tokla-chiya/VL53L9_KICAD/tmp/pdfs/reference-3.png

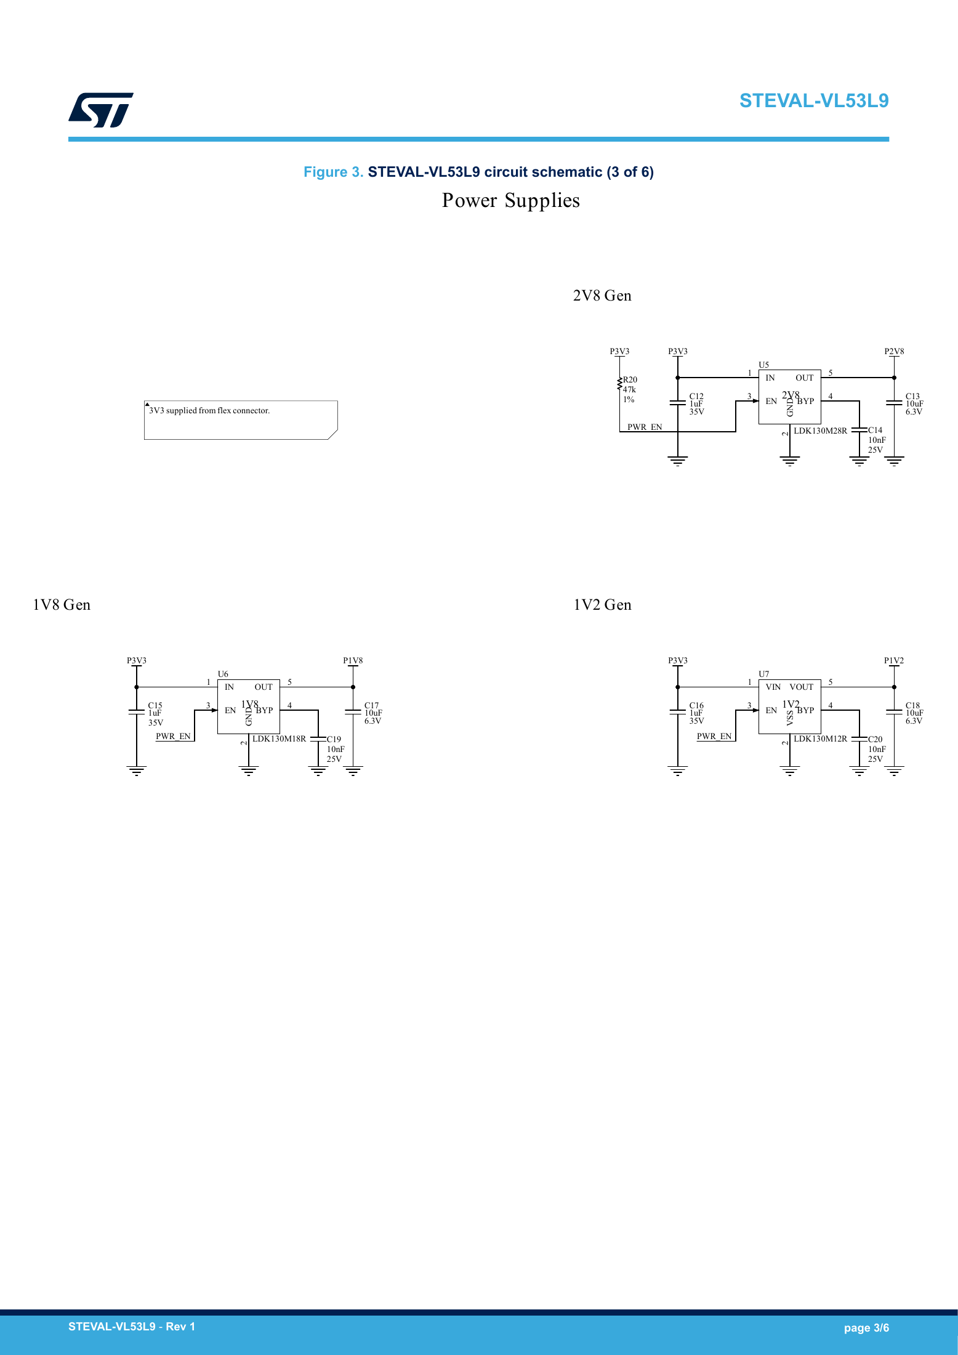
tmp/pdfs/reference-3.png
