tokla-chiya/VL53L9_KICAD/tmp/pdfs/reference-4.png

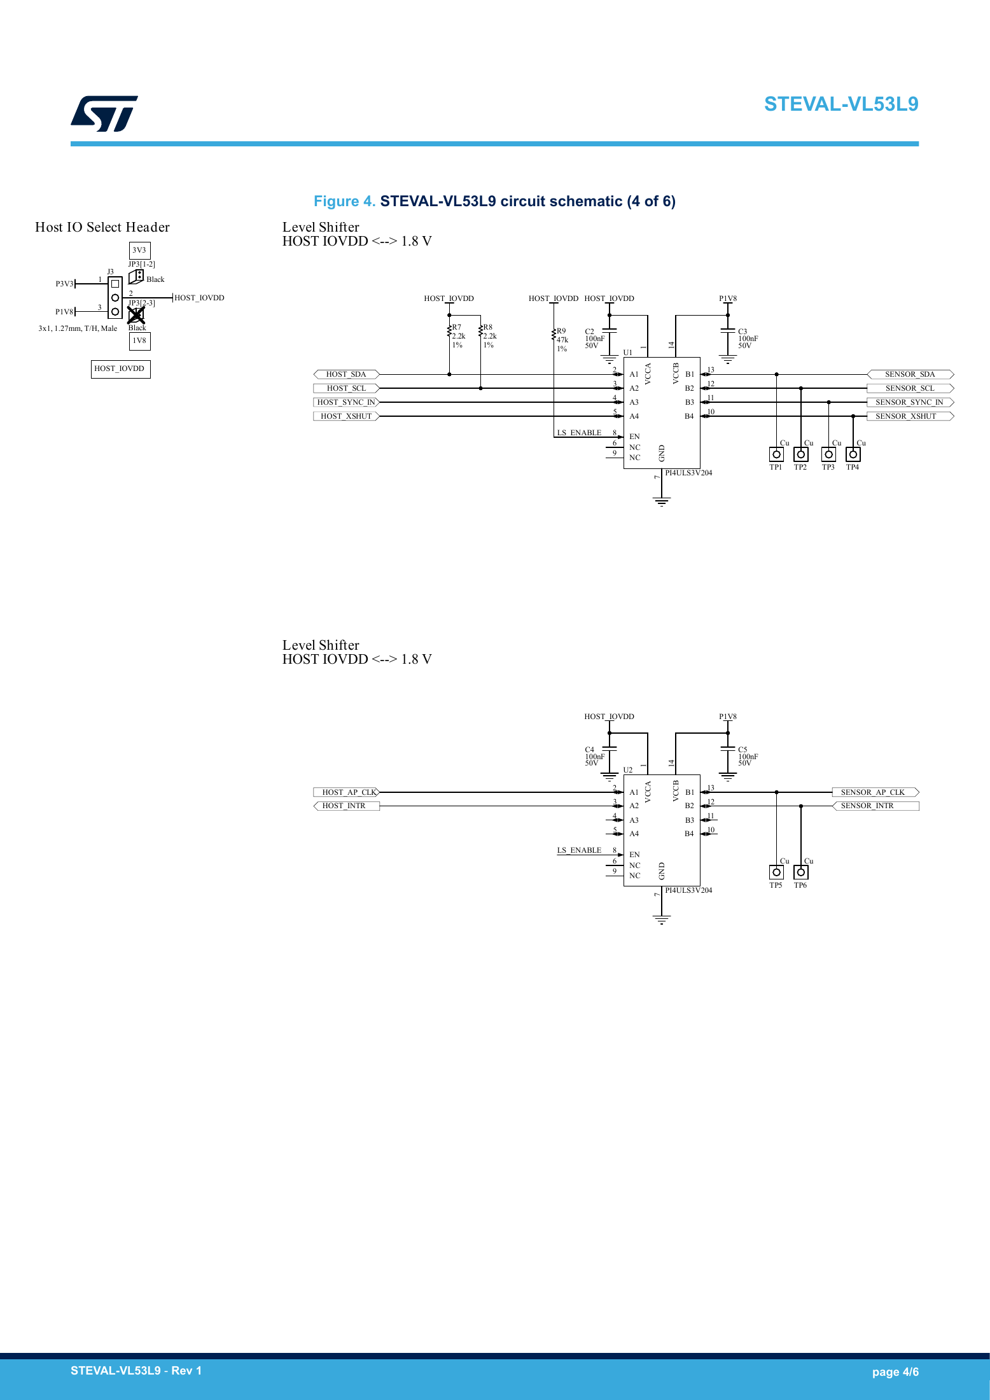
tmp/pdfs/reference-4.png
