tokla-chiya/VL53L9_KICAD/tmp/pdfs/reference-5.png

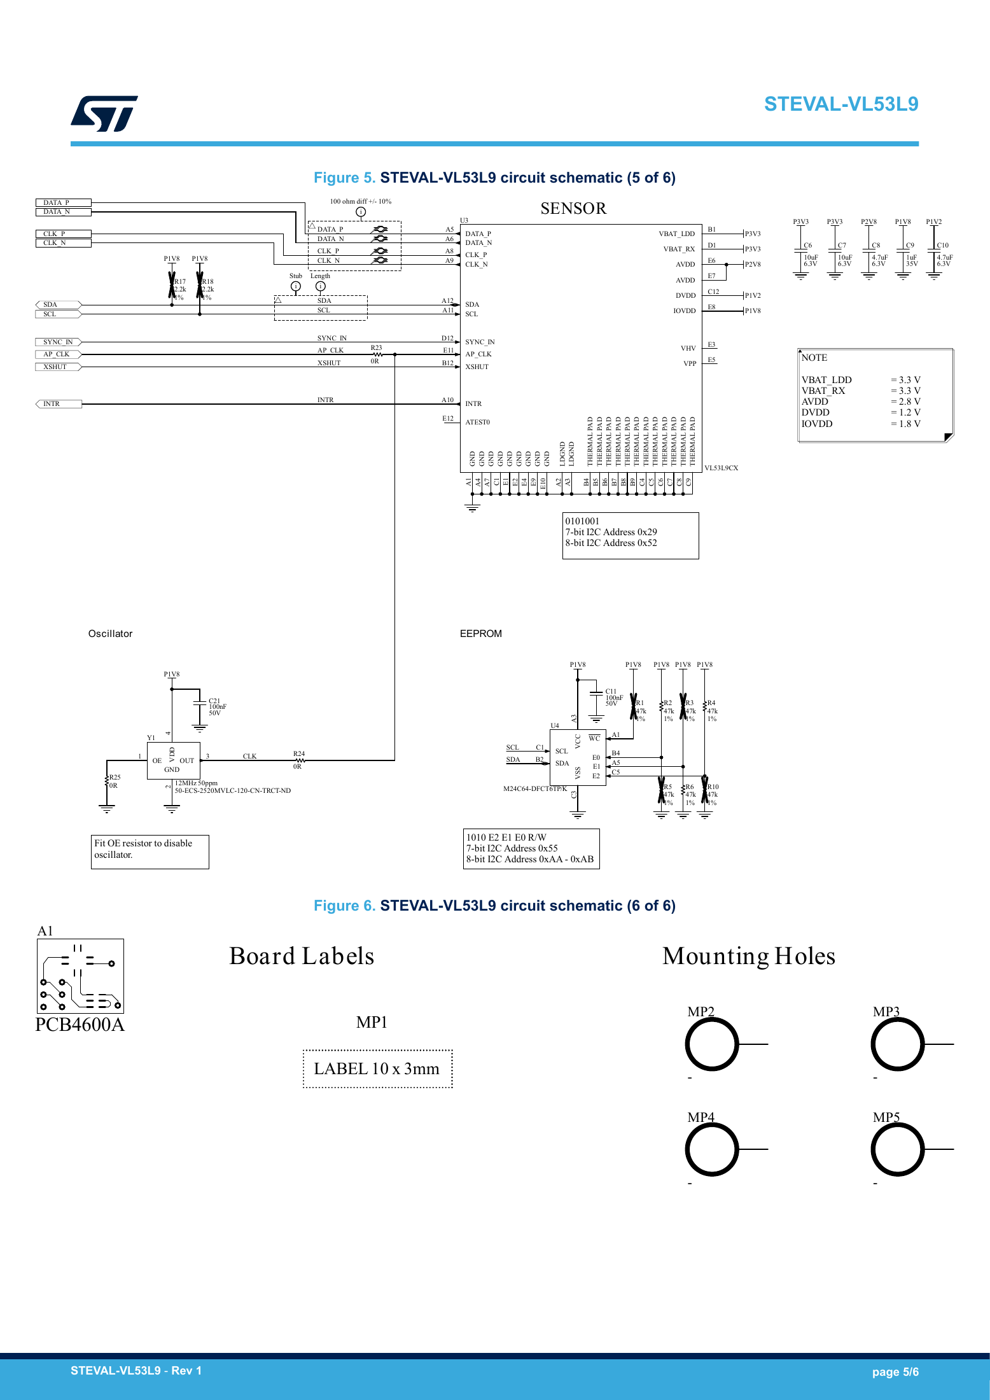
tmp/pdfs/reference-5.png
