tokla-chiya/VL53L9_KICAD/tmp/pdfs/schematic-preview.png

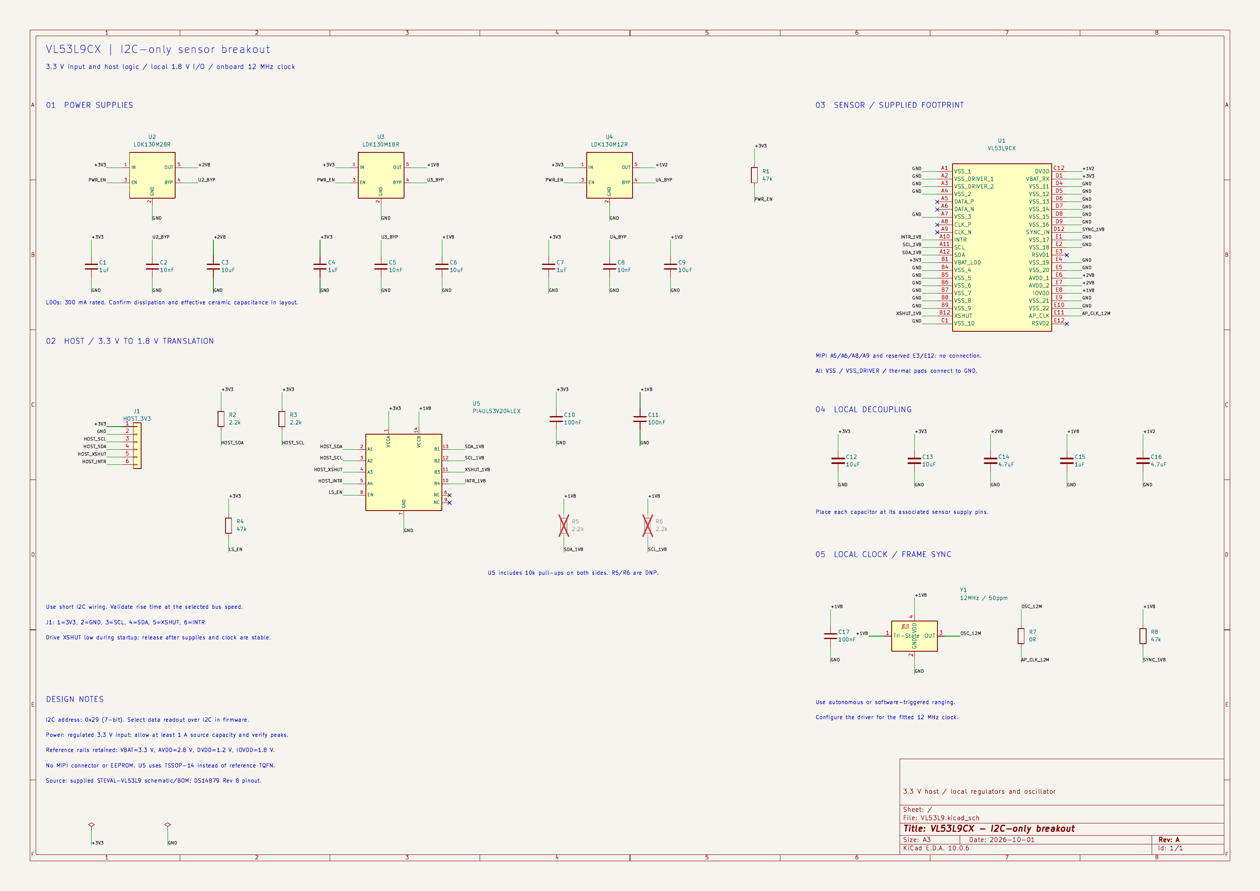
tmp/pdfs/schematic-preview.png
