tokla-chiya/VL53L9_KICAD/tmp/routing/placement-top.png

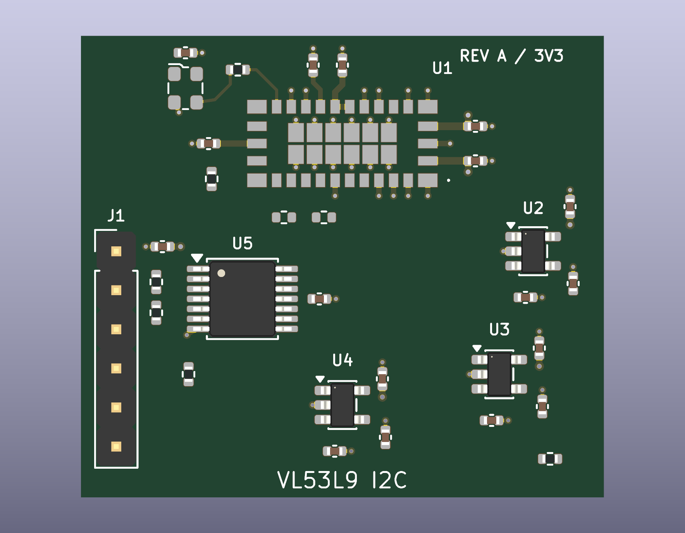
tmp/routing/placement-top.png
