tokla-chiya/VL53L9_KICAD/LIB_VL53L9CX/VL53L9CX/3D/VL53L9CX.stp

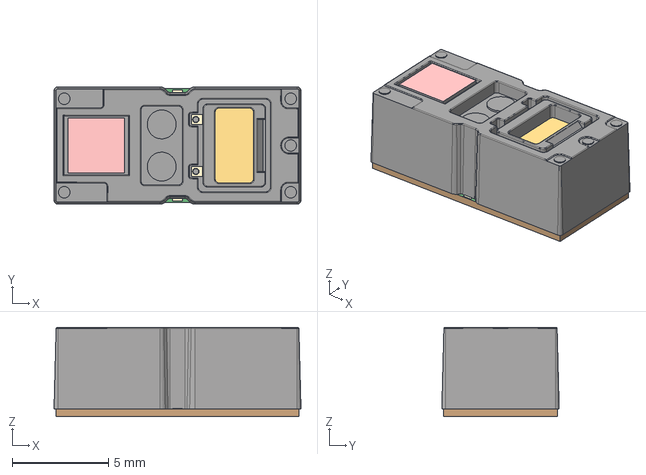
[picture p6: CAD file, 2026-10-02]
LIB_VL53L9CX/VL53L9CX/3D/VL53L9CX.stp
12.8 x 6.10 x 4.64 mm
