tokla-chiya/VL53L9_KICAD/(list of files, cad)

Other CAD files:
LIB_VL53L9CX/VL53L9CX/Allegro/vl53l9cx.psm
LIB_VL53L9CX/VL53L9CX/DEHDL/vl53l9cx/chips/chips.prt
