tokla-chiya/VL53L9_KICAD/(list of files, drawings)

Other design files:
LIB_VL53L9CX/VL53L9CX/Altium/VL53L9CX.PcbLib
LIB_VL53L9CX/VL53L9CX/Altium/VL53L9CX.SchLib
tmp/routing/VL53L9.dsn
