tokla-chiya/VL53L9_KICAD/VL53L9.kicad_pcb

## KiCad design VL53L9.kicad_pcb (2026-10-02)

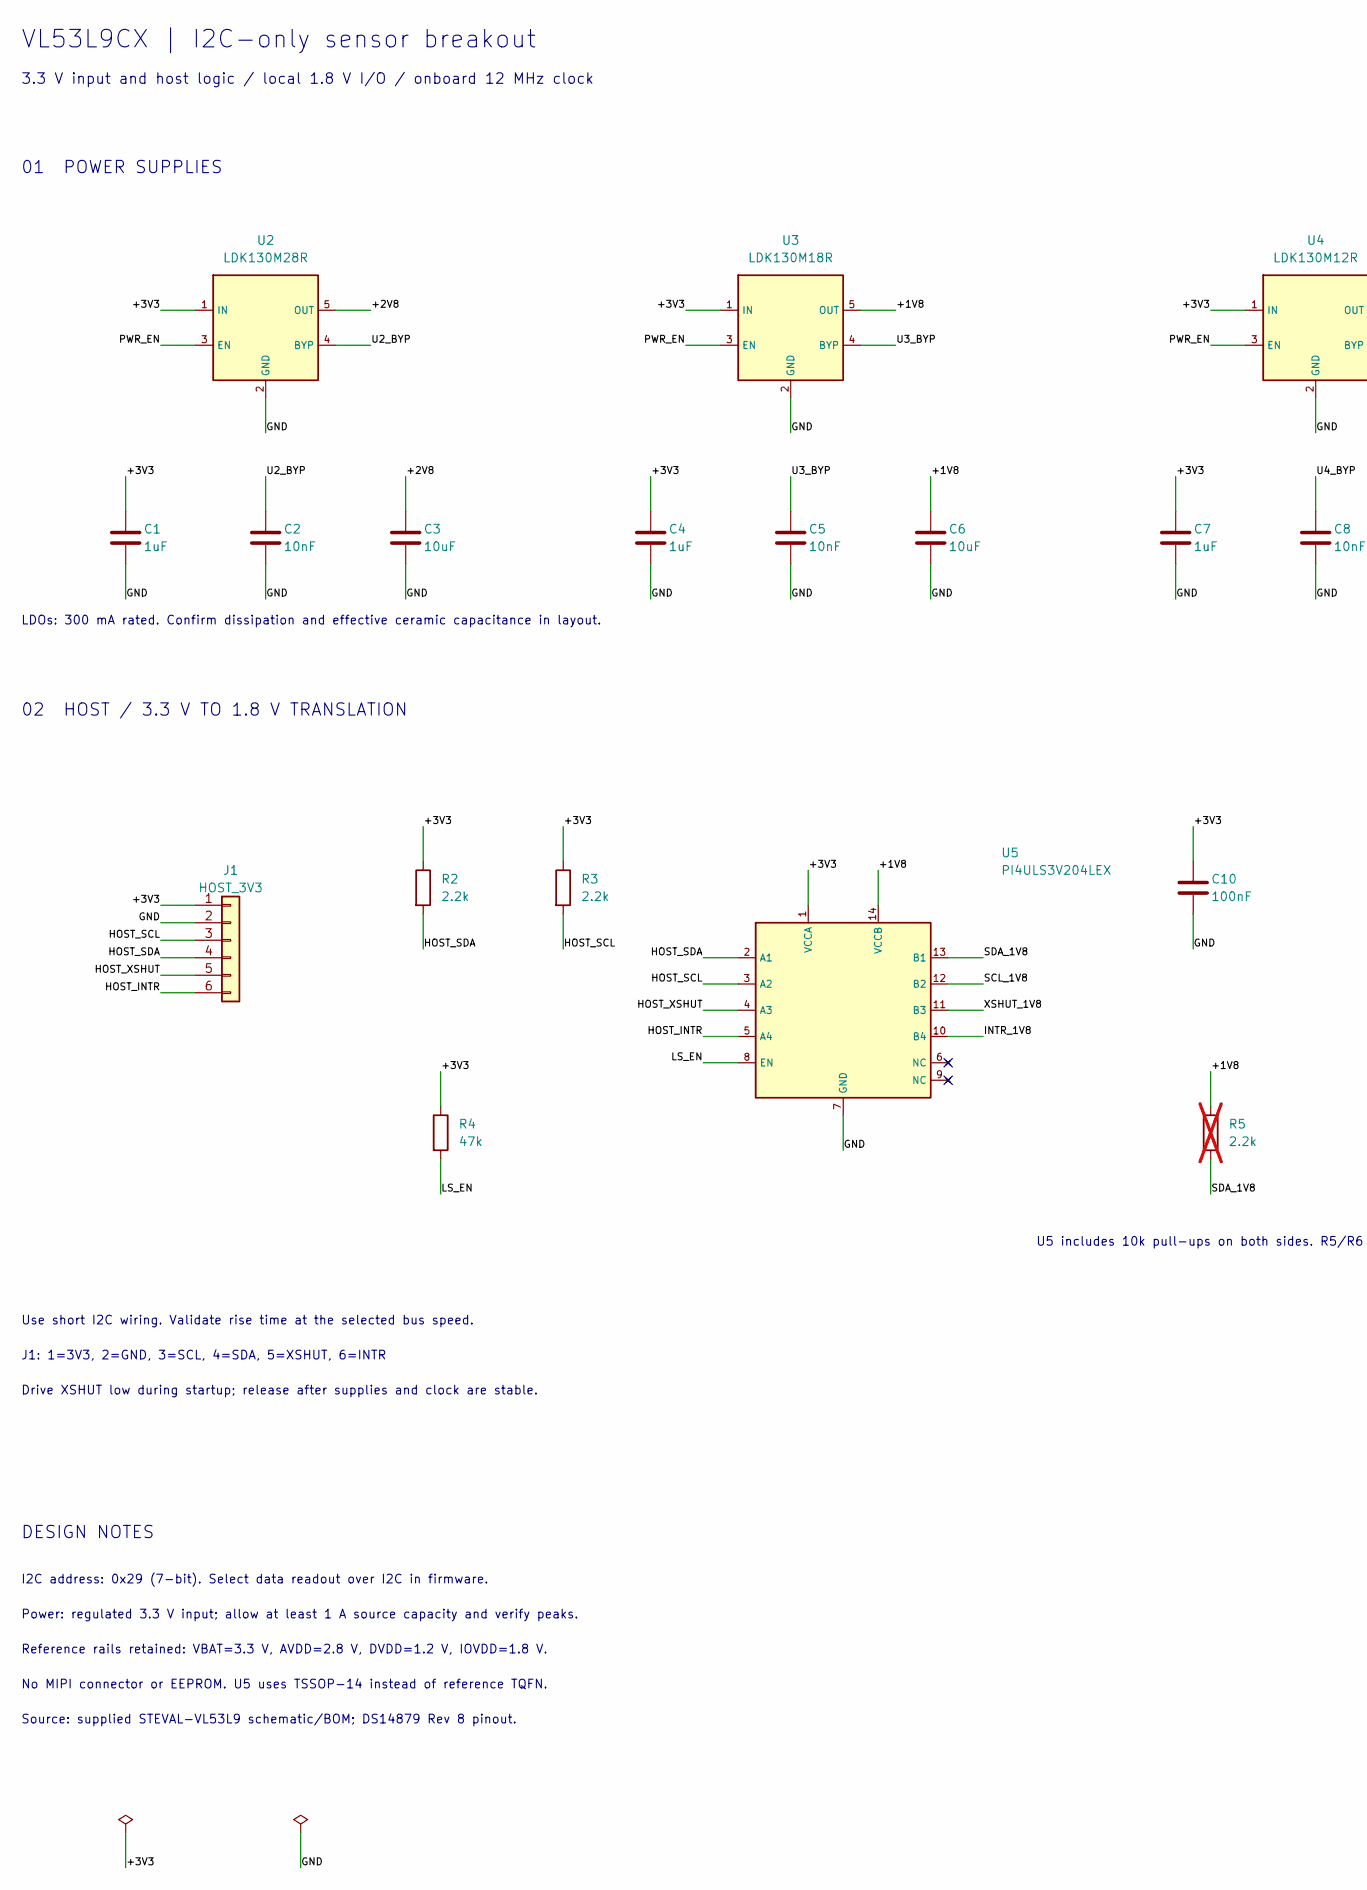
[picture p7: schematic VL53L9.kicad_sch, VL53L9CX - I2C-only breakout, part in row 1, column 1]

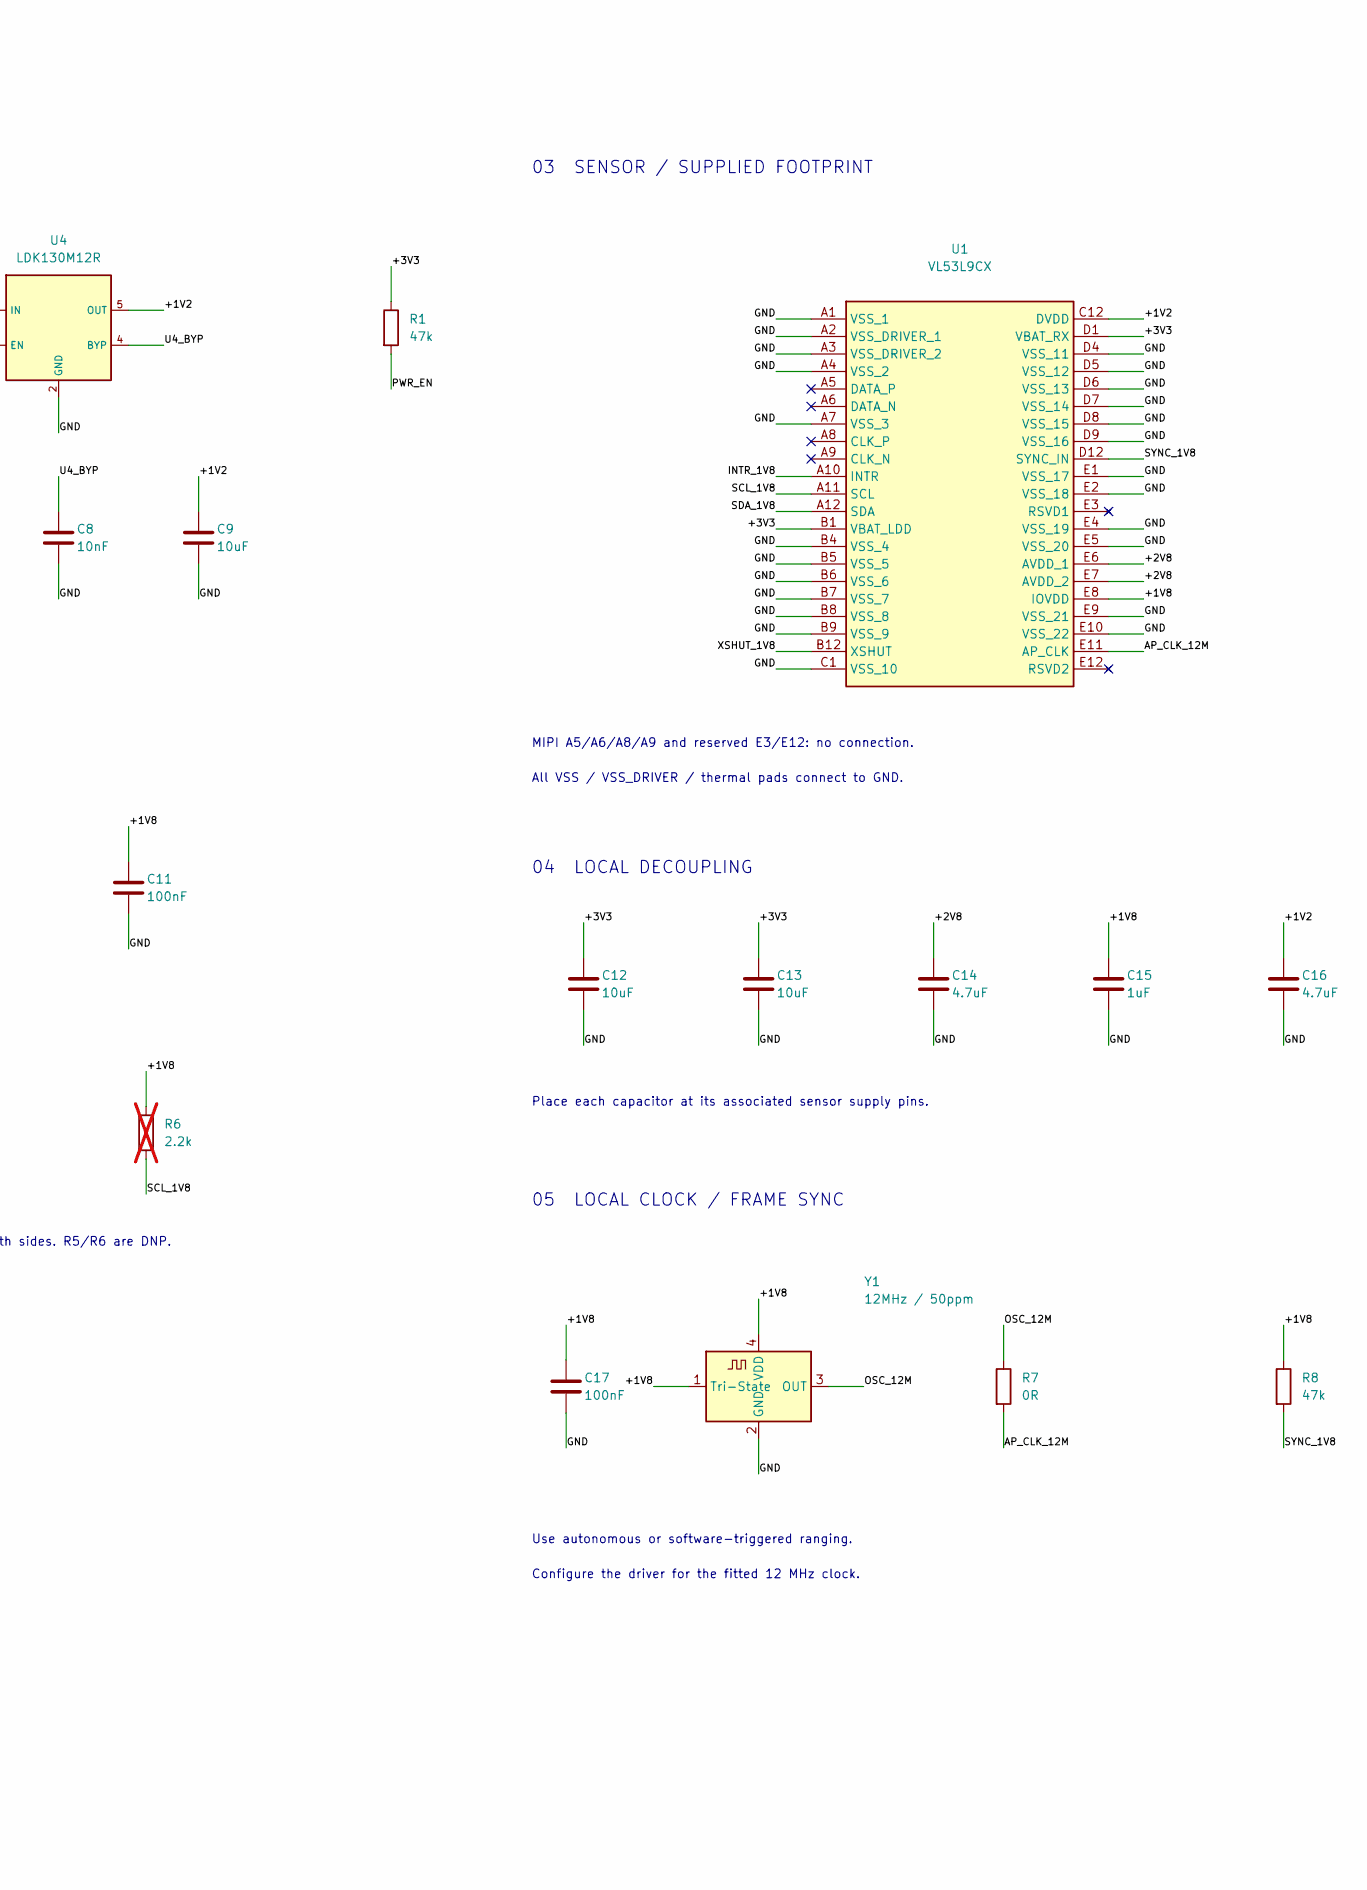
[picture p8: schematic VL53L9.kicad_sch, VL53L9CX - I2C-only breakout, part in row 1, column 2]

Parts:
C1, C4, C7, C15: 1uF; C_0402_1005Metric; MPN GRM155R6YA105KE11D
C2, C5, C8: 10nF; C_0402_1005Metric; MPN 04023D103KAT2A
C3, C6, C9, C12, C13: 10uF; C_0402_1005Metric; MPN GRJ155R60J106ME11D
C10, C11, C17: 100nF; C_0402_1005Metric; MPN GRT155R71H104KE01D
C14, C16: 4.7uF; C_0402_1005Metric; MPN C1005X5R0J475K050BC
J1: HOST_3V3; PinHeader_1x06_P2.54mm_Vertical
R1, R4, R8: 47k; R_0402_1005Metric; MPN ERJ2RKF4702X
R2, R3: 2.2k; R_0402_1005Metric; MPN RC0402FR-072K2L
R5, R6: 2.2k; R_0402_1005Metric; MPN RC0402FR-072K2L; not fitted
R7: 0R; R_0402_1005Metric; MPN RC0402JR-070RL
U1: VL53L9CX; MPN VL53L9CXV0VE/1
U2: LDK130M28R; SOT-23-5; MPN LDK130M28R
U3: LDK130M18R; SOT-23-5; MPN LDK130M18R
U4: LDK130M12R; SOT-23-5; MPN LDK130M12R
U5: PI4ULS3V204LEX; TSSOP-14_4.4x5mm_P0.65mm; MPN PI4ULS3V204LEX
Y1: 12MHz / 50ppm; Oscillator_SMD_ECS_2520MV-xxx-xx-4Pin_2.5x2.0mm; MPN ECS-2520MVLC-120-CN-TR

Connections:
/+1V2: C9.1, C16.1, U1.C12 (DVDD), U4.5 (OUT)
/+1V8: C6.1, C11.1, C15.1, C17.1, R5.1, R6.1, R8.1, U1.E8 (IOVDD), U3.5 (OUT), U5.14 (VCCB), Y1.1 (Tri-State), Y1.4 (VDD)
/+2V8: C3.1, C14.1, U1.E6 (AVDD_1), U1.E7 (AVDD_2), U2.5 (OUT)
/+3V3: C1.1, C4.1, C7.1, C10.1, C12.1, C13.1, J1.1, R1.1, R2.1, R3.1, R4.1, U1.B1 (VBAT_LDD), U1.D1 (VBAT_RX), U2.1 (IN), U3.1 (IN), U4.1 (IN), U5.1 (VCCA)
/AP_CLK_12M: R7.2, U1.E11 (AP_CLK)
/GND: C1.2, C2.2, C3.2, C4.2, C5.2, C6.2, C7.2, C8.2, C9.2, C10.2, C11.2, C12.2, C13.2, C14.2, C15.2, C16.2, C17.2, J1.2, U1.A1 (VSS_1), U1.A2 (VSS_DRIVER_1), U1.A3 (VSS_DRIVER_2), U1.A4 (VSS_2), U1.A7 (VSS_3), U1.B4 (VSS_4), U1.B5 (VSS_5), U1.B6 (VSS_6), U1.B7 (VSS_7), U1.B8 (VSS_8), U1.B9 (VSS_9), U1.C1 (VSS_10), U1.D4 (VSS_11), U1.D5 (VSS_12), U1.D6 (VSS_13), U1.D7 (VSS_14), U1.D8 (VSS_15), U1.D9 (VSS_16), U1.E1 (VSS_17), U1.E2 (VSS_18), U1.E4 (VSS_19), U1.E5 (VSS_20), U1.E9 (VSS_21), U1.E10 (VSS_22), U2.2 (GND), U3.2 (GND), U4.2 (GND), U5.7 (GND), Y1.2 (GND)
/HOST_INTR: J1.6, U5.5 (A4)
/HOST_SCL: J1.3, R3.2, U5.3 (A2)
/HOST_SDA: J1.4, R2.2, U5.2 (A1)
/HOST_XSHUT: J1.5, U5.4 (A3)
/INTR_1V8: U1.A10 (INTR), U5.10 (B4)
/LS_EN: R4.2, U5.8 (EN)
/OSC_12M: R7.1, Y1.3 (OUT)
/PWR_EN: R1.2, U2.3 (EN), U3.3 (EN), U4.3 (EN)
/SCL_1V8: R6.2, U1.A11 (SCL), U5.12 (B2)
/SDA_1V8: R5.2, U1.A12 (SDA), U5.13 (B1)
/SYNC_1V8: R8.2, U1.D12 (SYNC_IN)
/U2_BYP: C2.1, U2.4 (BYP)
/U3_BYP: C5.1, U3.4 (BYP)
/U4_BYP: C8.1, U4.4 (BYP)
/XSHUT_1V8: U1.B12 (XSHUT), U5.11 (B3)

Notes on the sheet:
VL53L9CX | I2C-only sensor breakout
3.3 V input and host logic / local 1.8 V I/O / onboard 12 MHz clock
01 POWER SUPPLIES
LDOs: 300 mA rated. Confirm dissipation and effective ceramic capacitance in layout.
02 HOST / 3.3 V TO 1.8 V TRANSLATION
U5 includes 10k pull-ups on both sides. R5/R6 are DNP.
Use short I2C wiring. Validate rise time at the selected bus speed.
J1: 1=3V3, 2=GND, 3=SCL, 4=SDA, 5=XSHUT, 6=INTR
Drive XSHUT low during startup; release after supplies and clock are stable.
03 SENSOR / SUPPLIED FOOTPRINT
MIPI A5/A6/A8/A9 and reserved E3/E12: no connection.
All VSS / VSS_DRIVER / thermal pads connect to GND.
04 LOCAL DECOUPLING
Place each capacitor at its associated sensor supply pins.
05 LOCAL CLOCK / FRAME SYNC
Use autonomous or software-triggered ranging.
Configure the driver for the fitted 12 MHz clock.
DESIGN NOTES
I2C address: 0x29 (7-bit). Select data readout over I2C in firmware.
Power: regulated 3.3 V input; allow at least 1 A source capacity and verify peaks.
Reference rails retained: VBAT=3.3 V, AVDD=2.8 V, DVDD=1.2 V, IOVDD=1.8 V.
No MIPI connector or EEPROM. U5 uses TSSOP-14 instead of reference TQFN.
Source: supplied STEVAL-VL53L9 schematic/BOM; DS14879 Rev 8 pinout.

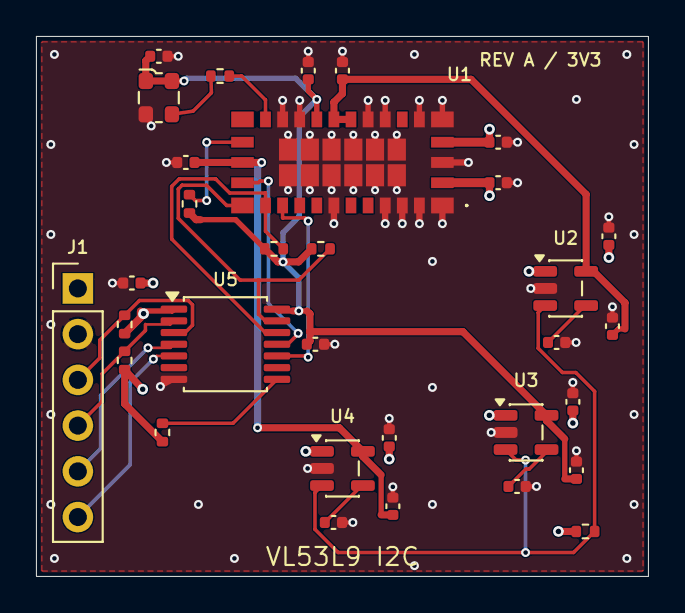
[picture p9: board VL53L9.kicad_pcb from above]

Board: 4 copper layers, 34.0 x 30.0 mm, 32 parts (0 on the bottom side), 21 nets.
